0x-irfan/Robot-ESP32-Avoider/(commit log)

2026-10-09 Update fmt.Println message from 'Hello' to 'Goodbye'
2026-10-09 Update README with project details and features
    Added detailed project description, features, and wiring diagrams for the Robot ESP32 Avoider.
2026-10-09 Fix image path for PCB Tampak Atas in README
2026-10-09 Fix image paths in README for schematic and PCB
    Updated image paths for schematic and PCB photos in README.
2026-10-09 Align PCB image widths in README
    Updated the width of the bottom PCB image to match the top PCB image.
2026-10-09 Update schematic image width in README
2026-10-11 Implement micro-ROS firmware for ESP32 robot
    This firmware implements a micro-ROS agent for the ESP32 robot, enabling telemetry and command handling. It includes motor control, distance sensing, and WiFi connectivity features.
2026-10-11 Modify sensor period and enhance WiFi connection logic
    Adjusted sensor reading frequency and WiFi connection handling.
2026-10-11 Add setup and usage instructions to readme
    Add instructions for running the R_Avoider ESP32 ROS2 project.
